tristanseifert/KiCad-TristLib/README.md

Here you'll find a collection of footprint and schematic symbol libraries for [KiCad 6](https://www.kicad.org) that I use in various projects.
