tristanseifert/KiCad-TristLib/(commit log)

2022-10-19 Initial batch of component footprints
    - These are taken from the Lichtenstein and Automashione projects
2022-10-19 Add even more footprints
    - These are from programmable load land
2022-10-20 Add symbol libraries
    - Created symbol libraries from programmable load, automashione and
    lichtnestein projects; linked them to the associated footprints
2023-01-02 add MYiR MYC-YA157C SoM footprint + symbol
2023-01-04 Add GCT microSD connector
2023-01-05 Added AP63300 switcher; start board-to-board lib
    - Create symbol for the AP63300 switching voltage regulator
    - Start work on footprint library for board-to-board (mezzanine)
    connectors
2023-01-05 Add more board-to-board headers
2023-01-05 Add symbols for ADS131M-series ADCs
    - Created symbols for the ADS131M02, ADS131M03, and ADS131M08
    sigma-delta simultaneously sampling 24-bit ADCs. They have 2, 3, or 8
    channels, respectively, and support up to 32kSPS with an SPI
    interface to read out data.
2023-01-10 Minor fixes to footprints, symbols
    - Also added a symbol for 74LVC138 3-to-8 decoder
2023-02-24 Add some connectors, transformer
    - Add basic plastic RJ45 connector (Amphenol RJHSE-508) footprint
    This can be used with the standard RJ45 with dual LEDs footprint that
    ships with KiCad.
    - Add Ethernet PoE+ flyback transformer (Pulse PA2467NL) symbol and
    footprint
2023-02-27 Add CAN transceivers, EEPROM symbols
    - Added symbols for MCP2542FD CAN transceiver
    - Added symbols for I2C EEPROMs: M24C32-RMN, 24FC08-T/OT
2023-02-28 Added various footprints, symbols
    - Antenna footprints: Coilcraft MA5532, with 3D model
    - RJ connectors: Amphenol RJE0164002, 90512-003LF, 54601 series (with 3D
    models)
    - Add symbol for KTS1622 IO expander
2023-03-01 Add various LED footprints
    - Created footprints for side-facing LEDs (Wurth 155124)
2023-03-01 Added CAN ESD diodes
    - Created a footprint for the PESD2CANFD24V CAN ESD diodes, which are
    compatible with higher CAN FD data rates.
2023-06-01 Add some components
    - Add DDR3L DRAM: IS43TR16128DL
    - Add PoE flyback switcher: MP8008
2023-06-01 Add eMMC, radio modules
    - Add Alliance ASFC4G31M eMMC, and BGA153 footprint for eMMC components
    - Add UBlox MAYA-W1 series modules
2023-06-01 Add i.MX6 ULZ
    - Add footprint, symbol for i.MX6 ULZ (MCIMX6Z0DVM09AB) SoC
2023-06-03 Add some switches, passives
    - Add footprints for Panasonic EVQP7C SMD tactile switch; Murata XRCGB
    crystal
    - Tweak iMX6 ULZ symbol
2023-06-07 Add some connectors and GreenPAK devices
    - Add Hirose DF40C series mezzanine connectors (currently, just the
    board plug type)
    - Added versions of TI regulators TLV6259x with power good outputs
    - Tweaks to MAYA-W160 footprint
    - Add GreenPAK device (SLG46826) and its associated STQFN-20L footprint
2023-06-11 Add some switches and connectors
    - Add receptale (3.0mm stack height) for Hirose DF40 series mezzanine
    - Add ESwitch 200AWMSP1T1A1M2QE toggle switch (PCB mount)
    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
2023-07-28 Add more connectors, terminal blocks
2023-07-29 Add CUI-TBL003 3 pin terminal block
2023-09-07 add some footprints
    - add footprints for Keystone 3568 miniature fuse holder
    - add footprints for some Amphenol connectors
    - add symbols for NAU7802 load cell ADC
2023-09-08 add motor driver parts library
    - this contains for now just the DRV8876 single H-bridge
2023-09-08 add BCR421U linear LED driver
2023-09-14 Add a bunch of stuff
    - symbols for a variety of power regulators and radio modules
    - add footprints for a whole load of things
2023-10-21 Add various SJ1-3535NG jacks
    - These are different colors and have 3D models; otherwise copied from
    KiCad connectors library
2023-10-21 Add TI power module, ESwitch TL-1260 switch
2023-10-21 Miscellaneous connectors and stuff
    - Add various connectors (Würth and JST)
    - Add some TI packages
    - Add MOSFETs (SiR638)
2023-10-27 add various RJ45 magjack, headphone jack footprints
2023-10-27 add various power and protection symbols
2023-10-31 Memory and connector stuff
    - Add symbols for 2x50 generic connector as well as for eMMC (Samsung KLM8G1GETF)
    - Add footprints for Amphenol 10144518 mezzanine connectors
2023-11-15 Add footprints for various terminal blocks
    - Add footprints for various CUI TB002-500 series screw terminal blocks
    (this has 2, 3, 4, 5, 6, and 8 positions)
    - Add footprint for Schurter UMT250 SMD fuses (copied from KiCad lib but
    adds 3D model)
2023-11-15 Add various isolation/power symbols
    - Add symbol for the AMC23C10 isolated comparator
    - Add symbol for ISP752R load switch
    - Add symbol for R05C05TE05S isolated DC/DC converter module
2024-01-16 Add TDK ACP3225 common mode choke footprint
2024-03-03 Add various power modules, RJ45 connectors
2024-03-07 Add Littelfuse 178.6765.0001 fuse holder
2024-03-09 Add some switch footprints
    - Adds E-Switch 400A series toggle switch; TL2205 push button (with LED
    indicator)
2024-03-09 Add CUI P783-series power modules
2024-03-09 Add E-Switch TL2250 symbol
2024-03-09 Add LP11O switch
2024-03-10 Add footprints for Abracon ARJM11D7; Quectel L76
2024-03-17 Add footprints for FFC connector; supercap
    - Footprints for Molex 52806-2010 and TE 2-1734839-4 FFC connectors;
    also the Abracon S05R5SA474 supercapacitors
2024-04-13 Add a variety of symbols and footprints
2024-04-13 Lots of connector footprints
    - Pluggable terminal blocks: CUI TBL0051, TBL003 series; Phoenix Contact
    1985234 series
    - Board to board connectors: Phoenix Contact 13371xx/13748xx
